limjh16/spike-batt-chg/3d Models/batt chg bambu file.3mf

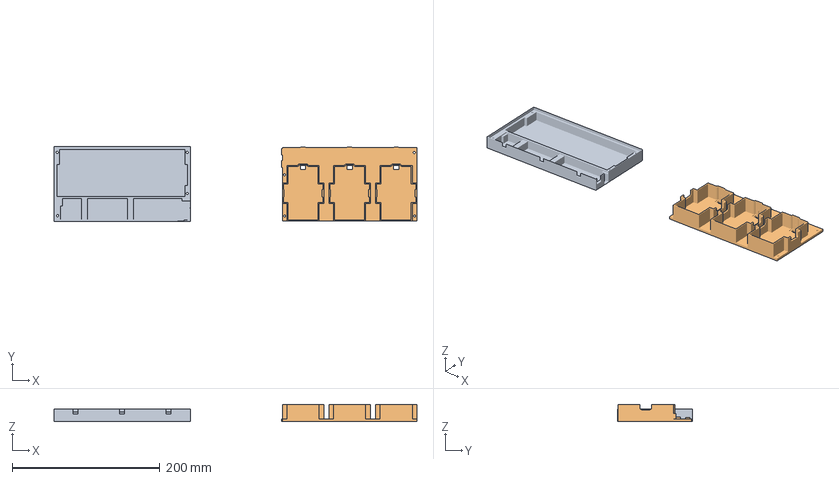
[picture p1: CAD file, 2024-05-21]
3d Models/batt chg bambu file.3mf
491.1 x 101.2 x 23.5 mm
Body2.stl
Body1.stl
