limjh16/spike-batt-chg/3d Models/DC Power Jack 5.5mm x 2.1mm.STEP

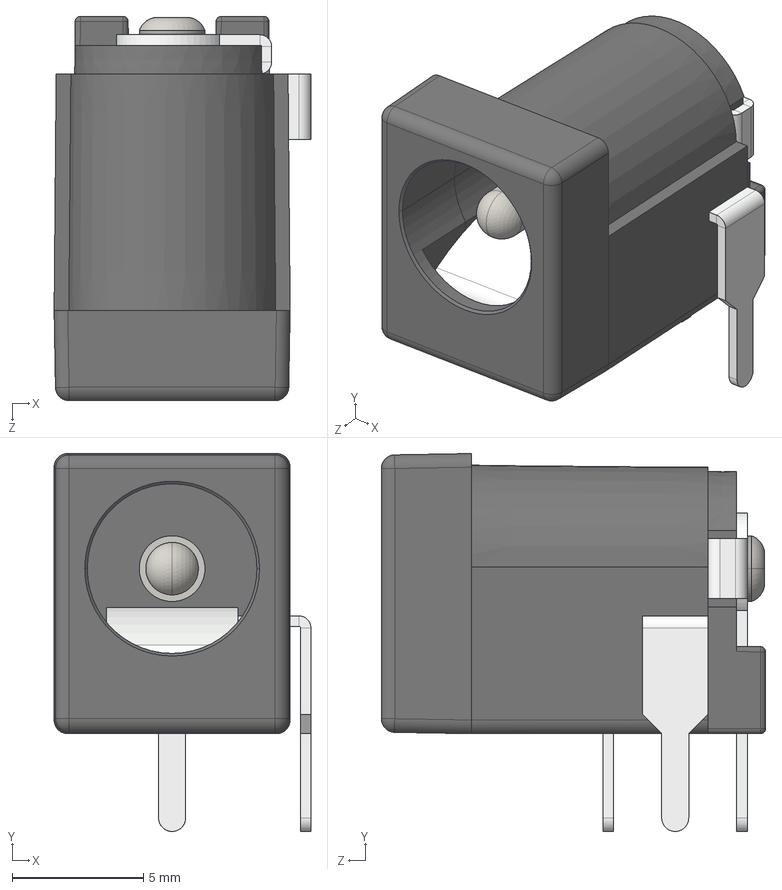
[picture p2: CAD file, 2023-06-22]
3d Models/DC Power Jack 5.5mm x 2.1mm.STEP
9.77 x 14.4 x 14.6 mm
