limjh16/spike-batt-chg/3d Models/USB Type C Port (SMD Type).STEP

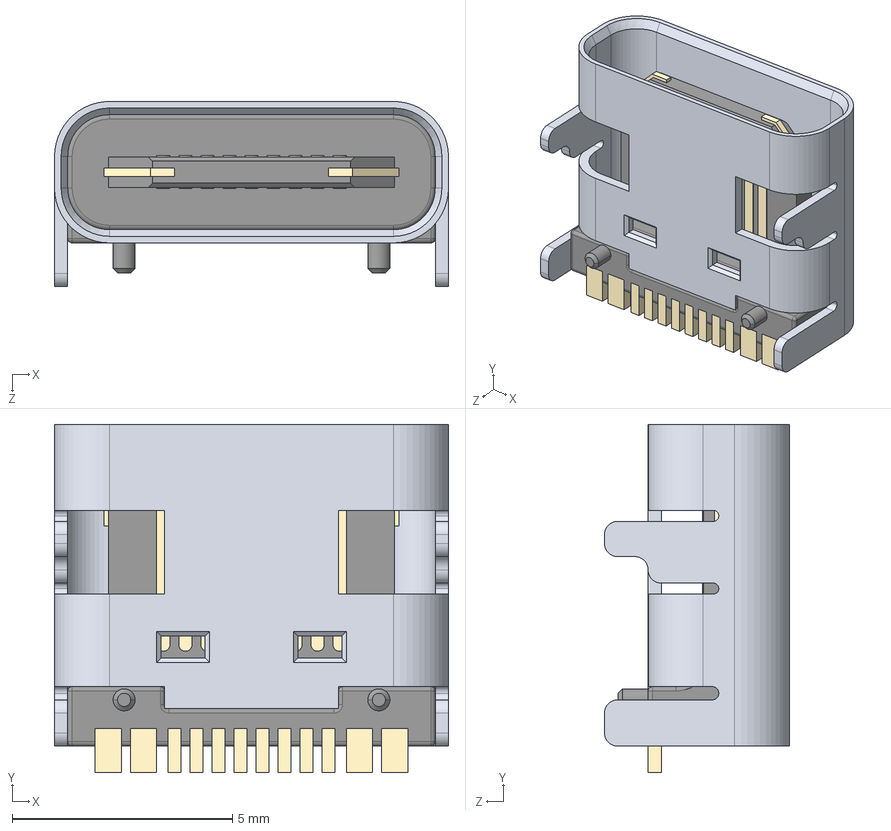
[picture p3: CAD file, 2023-06-22]
3d Models/USB Type C Port (SMD Type).STEP
8.94 x 7.90 x 4.20 mm
