limjh16/spike-batt-chg/SPIKE-batt-chg.kicad_pcb

## KiCad design SPIKE-batt-chg.kicad_pcb (2024-05-24)

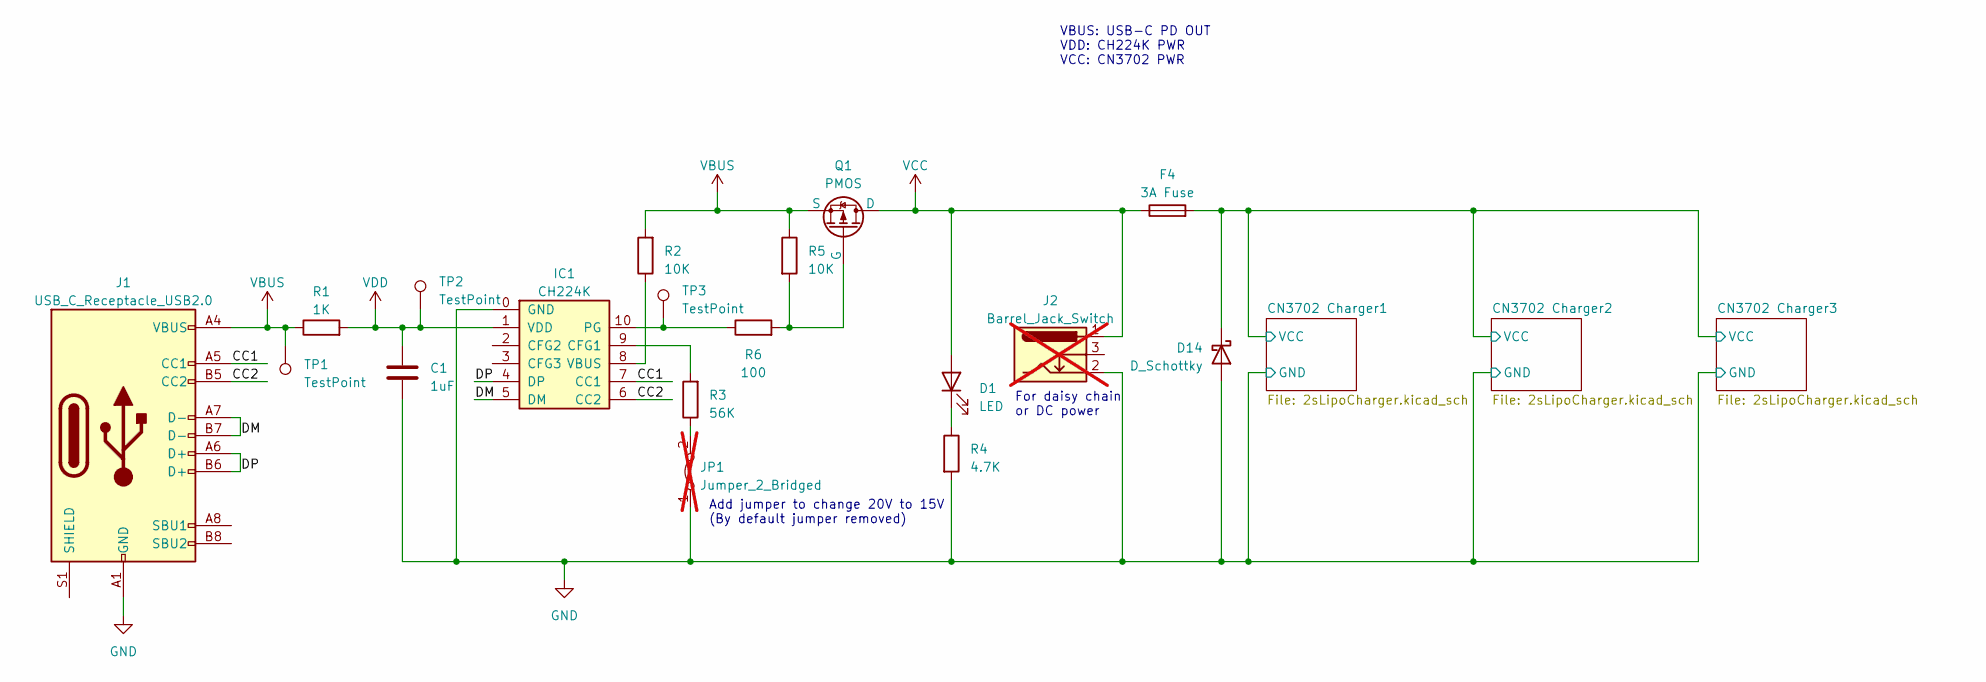
[picture p4: schematic SPIKE-batt-chg.kicad_sch]

Parts:
C1: 1uF; C_0603_1608Metric
D1: LED; LED_0603_1608Metric; Part XL-1606UGC; JLCPCB Part # C965863
D14: D_Schottky; D_SMA; Part SS54; JLCPCB Part # C22452
F4: 3A Fuse; Fuse_0603_1608Metric; Part F0603FA3000V032T; JLCPCB Part # C96544
IC1: CH224K; ESSOP-10_3.9x4.9mm_P1.00mm_EP2.3x3.2mm_ThermalVias
J1: USB_C_Receptacle_USB2.0; USB_C_Receptacle_XKB_U262-16XN-4BVC11; Part TYPE-C 16PIN 2MD(073); JLCPCB Part # C2765186
J2: Barrel_Jack_Switch; BarrelJack_Lock; not fitted
JP1: Jumper_2_Bridged; TestPoint_2Pads_Pitch2.54mm_Drill0.8mm; not fitted
Q1: PMOS; SOT-23; Part AO3401A; JLCPCB Part # C15127
R1: 1K; R_0603_1608Metric
R2, R5: 10K; R_0603_1608Metric
R3: 56K; R_0603_1608Metric
R4: 4.7K; R_0603_1608Metric
R6: 100; R_0603_1608Metric
TP1, TP2, TP3: TestPoint; TestPoint_Pad_D1.0mm

Connections:
/CC1: IC1.7 (CC1), J1.A5 (CC1)
/CC2: IC1.6 (CC2), J1.B5 (CC2)
/CN3702 Charger1/VCC: D14.1 (K), F4.2; also elsewhere on the board
/DM: IC1.5 (DM), J1.A7 (D-), J1.B7 (D-)
/DP: IC1.4 (DP), J1.A6 (D+), J1.B6 (D+)
GND: C1.2, D14.2 (A), IC1.0 (GND), J1.A1 (GND), J1.A12 (GND), J1.B1 (GND), J1.B12 (GND), J2.2, JP1.1 (A), R4.2; also elsewhere on the board
unnamed: D1.1 (K), R4.1
unnamed: IC1.9 (CFG1), R3.2
unnamed: IC1.10 (PG), R6.1, TP3.1
unnamed: IC1.8 (VBUS), R2.1
unnamed: JP1.2 (B), R3.1
unnamed: Q1.2 (G), R5.2, R6.2
VBUS: J1.A4 (VBUS), J1.A9 (VBUS), J1.B4 (VBUS), J1.B9 (VBUS), Q1.3 (S), R1.1, R2.2, R5.1, TP1.1
VCC: D1.2 (A), F4.1, J2.1, Q1.1 (D)
VDD: C1.1, IC1.1 (VDD), R1.2, TP2.1

Notes on the sheet:
VBUS: USB-C PD OUT VDD: CH224K PWR VCC: CN3702 PWR
For daisy chain or DC power
Add jumper to change 20V to 15V (By default jumper removed)

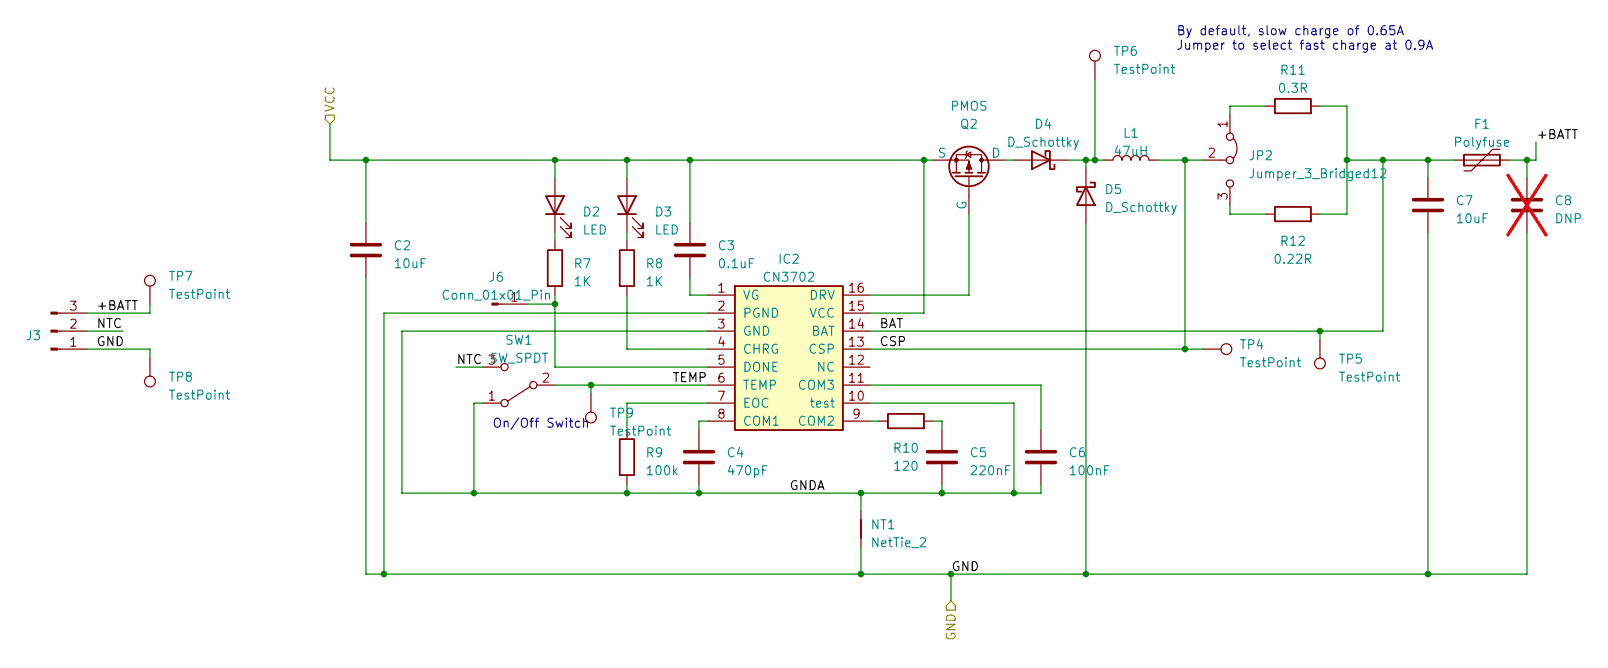
[picture p5: schematic 2sLipoCharger.kicad_sch]

Parts:
C2, C7: 10uF; C_0603_1608Metric
C3: 0.1uF; C_0603_1608Metric
C4: 470pF; C_0603_1608Metric
C5: 220nF; C_0603_1608Metric
C6: 100nF; C_0603_1608Metric
C8: DNP; C_0603_1608Metric; not fitted
D2: LED; LED_0603_1608Metric; Part XL-1606UGC; JLCPCB Part # C965863
D3: LED; LED_0603_1608Metric; Part XL-1606SURC; JLCPCB Part # C965860
D4, D5: D_Schottky; D_SOD-123; Part B5819W SL; JLCPCB Part # C8598
F1: Polyfuse; R_1812_4532Metric; Part MF-MSMF110/16-2; JLCPCB Part # C210834
IC2: CN3702; TSSOP-16_4.4x5mm_P0.65mm
J3: Conn_01x03_Pin; BladeConn_1x03_P2.00mm_Lock
J6: Conn_01x01_Pin; PinHeader_1x01_P2.54mm_Vertical
JP2: Jumper_3_Bridged12; 1X03_LOCK
L1: 47uH; L_Sunlord_SWPA6045S; Part YNR6045-470M; JLCPCB Part # C497841
NT1: NetTie_2; NetTie-2_SMD_Pad0.5mm
Q2: PMOS; SOT-23; Part AO3401A; JLCPCB Part # C15127
R7, R8: 1K; R_0603_1608Metric
R9: 100k; R_0603_1608Metric; JLCPCB Part # C25803
R10: 120; R_0603_1608Metric
R11: 0.3R; R_0603_1608Metric; Part FRL0603JR300TS; JLCPCB Part # C2934256
R12: 0.22R; R_0603_1608Metric; Part FRL0603FR220TS; JLCPCB Part # C3013347
SW1: SW_SPDT; SW_SPDT_PCM12; Part MSK12C02-HB; JLCPCB Part # C431541
TP4, TP5, TP6, TP7, TP8, TP9: TestPoint; TestPoint_Pad_D1.0mm

Connections:
/CN3702 Charger1/+BATT: C8.1, F1.2, J3.3, TP7.1
/CN3702 Charger1/BAT: C7.1, F1.1, IC2.14 (BAT), R11.2, R12.2, TP5.1
/CN3702 Charger1/CSP: IC2.13 (CSP), JP2.2 (C), L1.2, TP4.1
/CN3702 Charger1/GNDA: C4.2, C5.2, C6.2, IC2.3 (GND), IC2.10 (test), NT1.2, R9.2, SW1.1 (A)
/CN3702 Charger1/NTC: J3.2, SW1.3 (C)
/CN3702 Charger1/TEMP: IC2.6 (TEMP), SW1.2 (B), TP9.1
/CN3702 Charger1/VCC: C2.1, C3.1, D2.2 (A), D3.2 (A), IC2.15 (VCC), Q2.3 (S); also elsewhere on the board
GND: C2.2, C7.2, C8.2, D5.2 (A), IC2.2 (PGND), J3.1, NT1.1, TP8.1; also elsewhere on the board
unnamed: C5.1, R10.2
unnamed: D2.1 (K), R7.1
unnamed: D3.1 (K), R8.1
unnamed: D4.2 (A), Q2.1 (D)
unnamed: D4.1 (K), D5.1 (K), L1.1, TP6.1
unnamed: IC2.4 (CHRG), R8.2
unnamed: C4.1, IC2.8 (COM1)
unnamed: IC2.9 (COM2), R10.1
unnamed: C6.1, IC2.11 (COM3)
unnamed: IC2.5 (DONE), J6.1, R7.2
unnamed: IC2.16 (DRV), Q2.2 (G)
unnamed: IC2.7 (EOC), R9.1
unnamed: C3.2, IC2.1 (VG)
unnamed: JP2.1 (A), R11.1
unnamed: JP2.3 (B), R12.1

Parts of its further copies:
C9, C14, C16, C21: 10uF; C_0603_1608Metric
C10, C17: 0.1uF; C_0603_1608Metric
C11, C18: 470pF; C_0603_1608Metric
C12, C19: 220nF; C_0603_1608Metric
C13, C20: 100nF; C_0603_1608Metric
C15, C22: DNP; C_0603_1608Metric; not fitted
D6, D10: LED; LED_0603_1608Metric; Part XL-1606UGC; JLCPCB Part # C965863
D7, D11: LED; LED_0603_1608Metric; Part XL-1606SURC; JLCPCB Part # C965860
D8, D9, D12, D13: D_Schottky; D_SOD-123; Part B5819W SL; JLCPCB Part # C8598
F2, F3: Polyfuse; R_1812_4532Metric; Part MF-MSMF110/16-2; JLCPCB Part # C210834
IC3, IC4: CN3702; TSSOP-16_4.4x5mm_P0.65mm
J4, J5: Conn_01x03_Pin; BladeConn_1x03_P2.00mm_Lock
J7, J8: Conn_01x01_Pin; PinHeader_1x01_P2.54mm_Vertical
JP3, JP4: Jumper_3_Bridged12; 1X03_LOCK
L2, L3: 47uH; L_Sunlord_SWPA6045S; Part YNR6045-470M; JLCPCB Part # C497841
NT2, NT3: NetTie_2; NetTie-2_SMD_Pad0.5mm
Q3, Q4: PMOS; SOT-23; Part AO3401A; JLCPCB Part # C15127
R13, R14, R19, R20: 1K; R_0603_1608Metric
R15, R21: 100k; R_0603_1608Metric; JLCPCB Part # C25803
R16, R22: 120; R_0603_1608Metric
R17, R23: 0.3R; R_0603_1608Metric; Part FRL0603JR300TS; JLCPCB Part # C2934256
R18, R24: 0.22R; R_0603_1608Metric; Part FRL0603FR220TS; JLCPCB Part # C3013347
SW2, SW3: SW_SPDT; SW_SPDT_PCM12; Part MSK12C02-HB; JLCPCB Part # C431541
TP10, TP11, TP12, TP13, TP14, TP15, TP16, TP17, TP18, TP19, TP20, TP21: TestPoint; TestPoint_Pad_D1.0mm

Connections of its further copies:
/CN3702 Charger1/VCC: C9.1, C10.1, C16.1, C17.1, D6.2 (A), D7.2 (A), D10.2 (A), D11.2 (A), IC3.15 (VCC), IC4.15 (VCC), Q3.3 (S), Q4.3 (S); also elsewhere on the board
/CN3702 Charger2/+BATT: C15.1, F2.2, J4.3, TP10.1
/CN3702 Charger2/BAT: C14.1, F2.1, IC3.14 (BAT), R17.2, R18.2, TP15.1
/CN3702 Charger2/CSP: IC3.13 (CSP), JP3.2 (C), L2.2, TP14.1
/CN3702 Charger2/GNDA: C11.2, C12.2, C13.2, IC3.3 (GND), IC3.10 (test), NT2.2, R15.2, SW2.1 (A)
/CN3702 Charger2/NTC: J4.2, SW2.3 (C)
/CN3702 Charger2/TEMP: IC3.6 (TEMP), SW2.2 (B), TP12.1
/CN3702 Charger3/+BATT: C22.1, F3.2, J5.3, TP16.1
/CN3702 Charger3/BAT: C21.1, F3.1, IC4.14 (BAT), R23.2, R24.2, TP21.1
/CN3702 Charger3/CSP: IC4.13 (CSP), JP4.2 (C), L3.2, TP20.1
/CN3702 Charger3/GNDA: C18.2, C19.2, C20.2, IC4.3 (GND), IC4.10 (test), NT3.2, R21.2, SW3.1 (A)
/CN3702 Charger3/NTC: J5.2, SW3.3 (C)
/CN3702 Charger3/TEMP: IC4.6 (TEMP), SW3.2 (B), TP18.1
GND: C9.2, C14.2, C15.2, C16.2, C21.2, C22.2, D9.2 (A), D13.2 (A), IC3.2 (PGND), IC4.2 (PGND), J4.1, J5.1, NT2.1, NT3.1, TP11.1, TP17.1; also elsewhere on the board
unnamed: C12.1, R16.2
unnamed: C19.1, R22.2
unnamed: D6.1 (K), R13.1
unnamed: D7.1 (K), R14.1
unnamed: D8.2 (A), Q3.1 (D)
unnamed: D8.1 (K), D9.1 (K), L2.1, TP13.1
unnamed: D10.1 (K), R19.1
unnamed: D11.1 (K), R20.1
unnamed: D12.2 (A), Q4.1 (D)
unnamed: D12.1 (K), D13.1 (K), L3.1, TP19.1
unnamed: IC3.4 (CHRG), R14.2
unnamed: C11.1, IC3.8 (COM1)
unnamed: IC3.9 (COM2), R16.1
unnamed: C13.1, IC3.11 (COM3)
unnamed: IC3.5 (DONE), J7.1, R13.2
unnamed: IC3.16 (DRV), Q3.2 (G)
unnamed: IC3.7 (EOC), R15.1
unnamed: C10.2, IC3.1 (VG)
unnamed: IC4.4 (CHRG), R20.2
unnamed: C18.1, IC4.8 (COM1)
unnamed: IC4.9 (COM2), R22.1
unnamed: C20.1, IC4.11 (COM3)
unnamed: IC4.5 (DONE), J8.1, R19.2
unnamed: IC4.16 (DRV), Q4.2 (G)
unnamed: IC4.7 (EOC), R21.1
unnamed: C17.2, IC4.1 (VG)
unnamed: JP3.1 (A), R17.1
unnamed: JP3.3 (B), R18.1
unnamed: JP4.1 (A), R23.1
unnamed: JP4.3 (B), R24.1

Notes on the sheet:
By default, slow charge of 0.65A Jumper to select fast charge at 0.9A
On/Off Switch

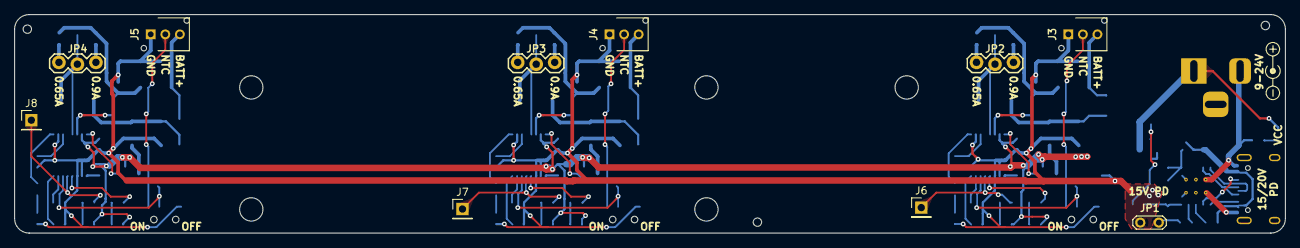
[picture p6: board SPIKE-batt-chg.kicad_pcb from above]

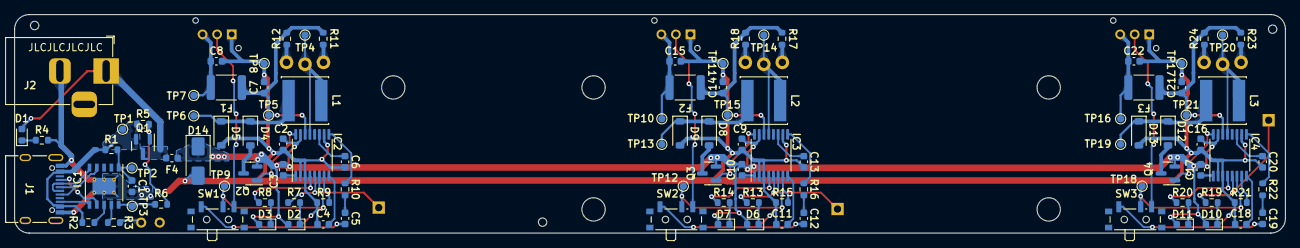
[picture p7: board SPIKE-batt-chg.kicad_pcb from below]

Board: 2 copper layers, 174.5 x 30.0 mm, 114 parts (104 on the bottom side), 78 nets.
