limjh16/spike-batt-chg/(commit log)

2023-05-20 Initial Commit: USB-C PD done
    [SPIKE-batt-chg.kicad_pcb, SPIKE-batt-chg.kicad_sch]
2023-05-22 Finished CN3702 battery charging IC schematic
    Added PG switch for CN3702, since the UVLO(min) is 4.6V
    Yet to do: selection of schottky diode and power PMOS
    [SPIKE-batt-chg.kicad_sch]
2023-05-22 Split charger into hierarchical sheets 4 charging circuits will be on the board Added jumper for PD voltage selection (9V or 20V) Added SPDT switch to TEMP pin to turn on/off charger
    [2sLipoCharger.kicad_sch, SPIKE-batt-chg.kicad_sch]
2023-05-23 Finished Schematic
    - Cleaned up page 1
    - Only 3 chargers / board now
    - LED no longer activated by PG, connected to VCC after the P-MOSFET instead
    - Added DC barrel jack for daisy chaining (using M-M 30cm cable)
    - Added jumper to enable fast charge
    - Selected inductor, diode, P-MOSFET, current sense resistor
    - Changed slide switch to 90 degree
    [2sLipoCharger.kicad_sch, SPIKE-batt-chg.kicad_sch]
2023-05-25 Footprint assignment partially done
    - incomplete: minor edit of footprints, locking pin header footprints
    - changed LEDs to side facing, changed PG LED resistor to 4.7k since
    will be going through 20V
    [2sLipoCharger.kicad_sch, SPIKE-batt-chg.kicad_sch]
2023-05-26 Finished footprint assignments, added testpoints
    - Added polyfuse
    - Cleaned up schematic (mirrored some components for clarity)
    [2sLipoCharger.kicad_sch, SPIKE-batt-chg.kicad_sch]
2023-05-26 Edited DRC, started layout
    [2sLipoCharger.kicad_sch, SPIKE-batt-chg.kicad_pcb, SPIKE-batt-chg.kicad_sch]
2023-05-28 CH224K Board Layout complete
    - Partial layout of CN3702
    - Fixed the incorrect NetTie on 2sLipoCharger.kicad_sch (More things are supposed to go to AGND)
    [2sLipoCharger.kicad_sch, SPIKE-batt-chg.kicad_pcb, SPIKE-batt-chg.kicad_sch]
2023-05-29 Finished charger layout
    - Replace global power symbols in charger schematic with local labels
    [2sLipoCharger.kicad_sch, SPIKE-batt-chg.kicad_pcb]
2023-05-29 Finished layout
    - DRC checked, outline complete
    - Left to do: silkscreen
    [SPIKE-batt-chg.kicad_pcb]
2023-05-31 Added fuse and shunt diode
    For reverse polarity protection
    [SPIKE-batt-chg.kicad_pcb, SPIKE-batt-chg.kicad_sch]
2023-05-31 Added tooling and mounting holes
    - Added pinout for "done" pin on charger for future use
    [2sLipoCharger.kicad_sch, SPIKE-batt-chg.kicad_pcb]
2023-05-31 Change grid origin, generate production files
    [SPIKE-batt-chg.kicad_pcb, bom.csv, designators.csv, positions.csv]
2023-05-31 Exclude header pins from BOM
    [2sLipoCharger.kicad_sch, SPIKE-batt-chg.kicad_pcb]
2023-06-18 Fixed problems after PCB fab
    - SOT23 MOSFET footprint does not match part, needs to rotate (rerouting
    not done yet)
    - EOC Resistor set to 100k
    [2sLipoCharger.kicad_sch, SPIKE-batt-chg.kicad_pcb]
2023-06-22 Updated 3D models
    [DC Power Jack 5.5mm x 2.1mm.STEP, SPIKE-batt-chg.kicad_pcb, USB Type C Port (SMD Type).STEP]
2024-05-21 add 3mf file for the 3d printed casing
    [batt chg bambu file.3mf]
2024-05-21 Fix the routing for rotated MOSFET
    [2sLipoCharger.kicad_sch, SPIKE-batt-chg.kicad_pcb, SPIKE-batt-chg.kicad_sch]
2024-05-24 fixes, drc check
    [SPIKE-batt-chg.kicad_pcb]
2024-05-24 update JLCPCB part for R9,15,21
    [2sLipoCharger.kicad_sch, SPIKE-batt-chg.kicad_pcb]
2024-05-24 fill zones, generated updated gerber and BOM
    [SPIKE-batt-chg.kicad_pcb, bom.csv]
